sanghotran/CNCMicaMini/Software/CNCMicaMiniWPF/Images/debugscreen.png

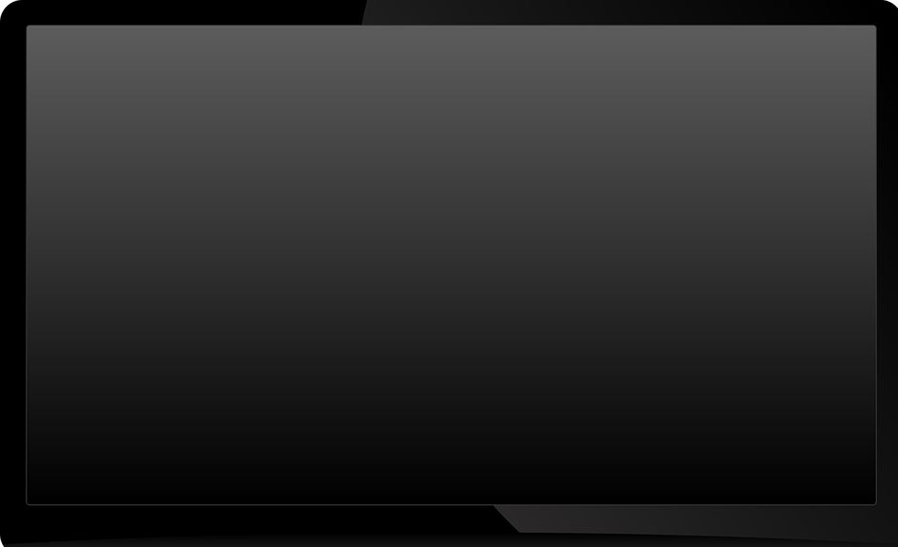
Software/CNCMicaMiniWPF/Images/debugscreen.png
