sanghotran/CNCMicaMini/Software/CNCMicaMiniWPF/Images/Debug.png

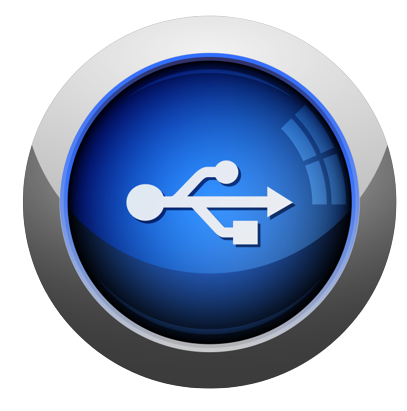
Software/CNCMicaMiniWPF/Images/Debug.png
