sanghotran/CNCMicaMini/Software/CNCMicaMiniWPF/packages/System.Buffers.4.4.0/version.txt

8321c729934c0f8be754953439b88e6e1c120c24
