sanghotran/CNCMicaMini/Hardware/Product/top.jpg

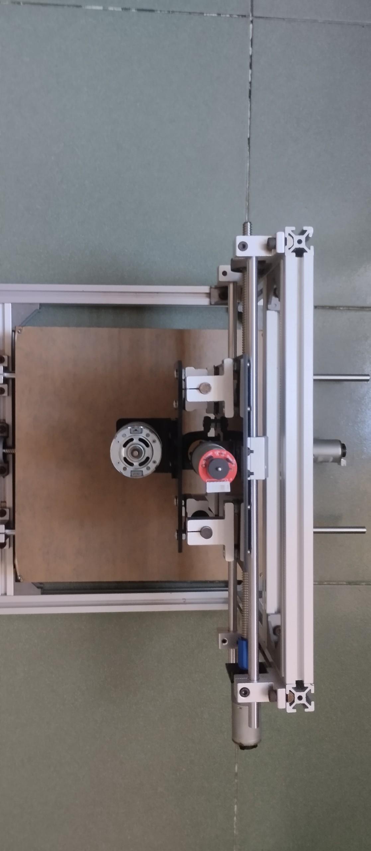
Hardware/Product/top.jpg
