sanghotran/CNCMicaMini/Software/CNCMicaMiniWPF/Images/-.png

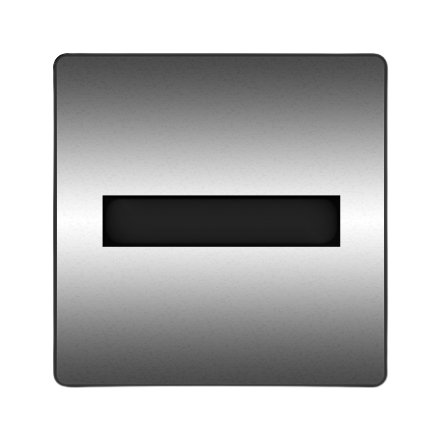
Software/CNCMicaMiniWPF/Images/-.png
