sanghotran/CNCMicaMini/Software/CNCMicaMiniWPF/Images/bluebutton.png

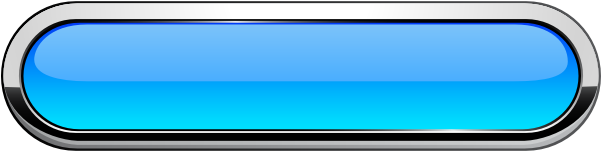
Software/CNCMicaMiniWPF/Images/bluebutton.png
