sanghotran/CNCMicaMini/Software/CNCMicaMiniWPF/Images/blueframeneon.png

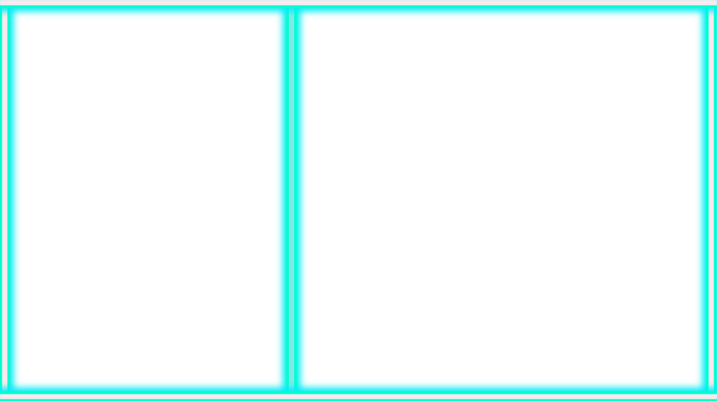
Software/CNCMicaMiniWPF/Images/blueframeneon.png
