sanghotran/CNCMicaMini/Software/CNCMicaMiniWPF/Images/downarrow.png

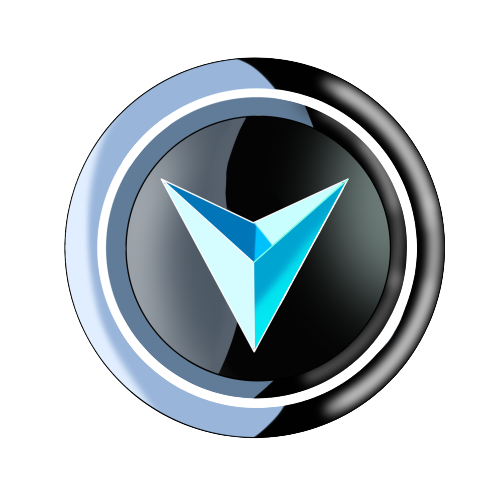
Software/CNCMicaMiniWPF/Images/downarrow.png
