sanghotran/CNCMicaMini/Software/CNCMicaMiniWPF/Images/gblueframeneon.png

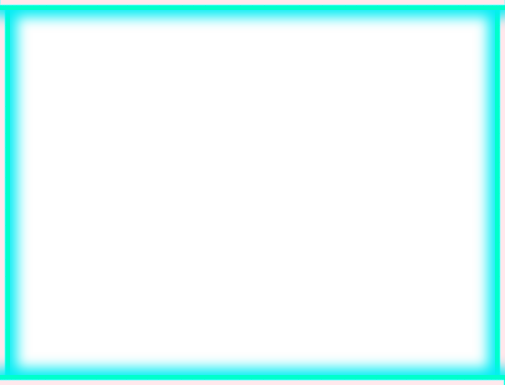
Software/CNCMicaMiniWPF/Images/gblueframeneon.png
