sanghotran/CNCMicaMini/Software/CNCMicaMiniWPF/Images/Home.png

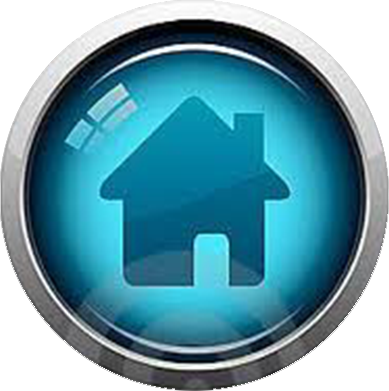
Software/CNCMicaMiniWPF/Images/Home.png
