sanghotran/CNCMicaMini/Software/CNCMicaMiniWPF/Images/leftarrow.png

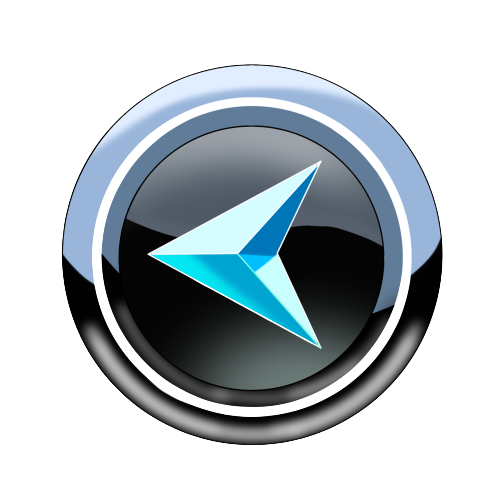
Software/CNCMicaMiniWPF/Images/leftarrow.png
