sanghotran/CNCMicaMini/Software/CNCMicaMiniWPF/Images/redarrowneon.png

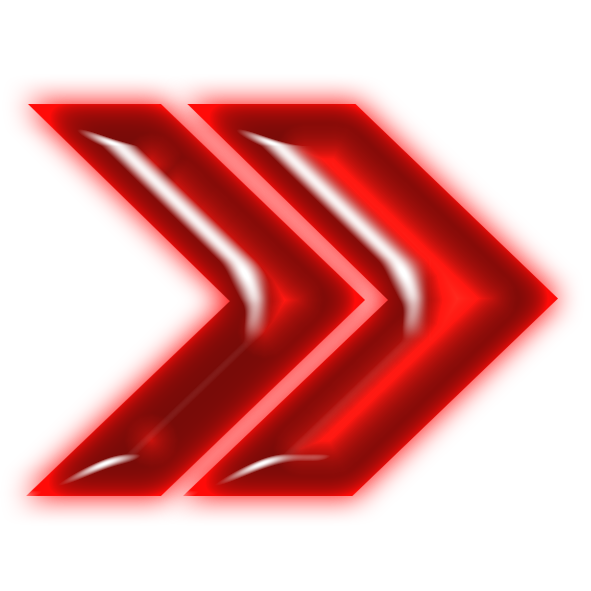
Software/CNCMicaMiniWPF/Images/redarrowneon.png
