sanghotran/CNCMicaMini/Software/CNCMicaMiniWPF/Images/rightarrow.png

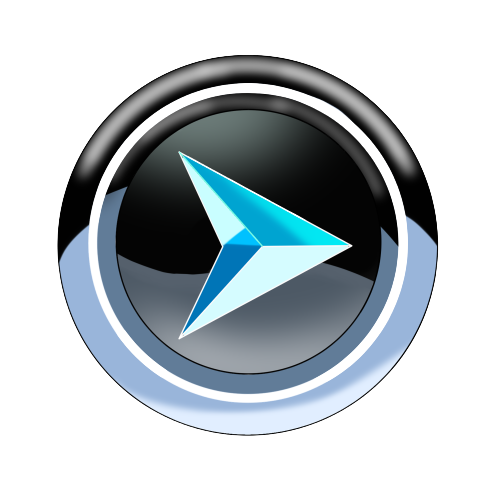
Software/CNCMicaMiniWPF/Images/rightarrow.png
