sanghotran/CNCMicaMini/Software/CNCMicaMiniWPF/Images/uparrow.png

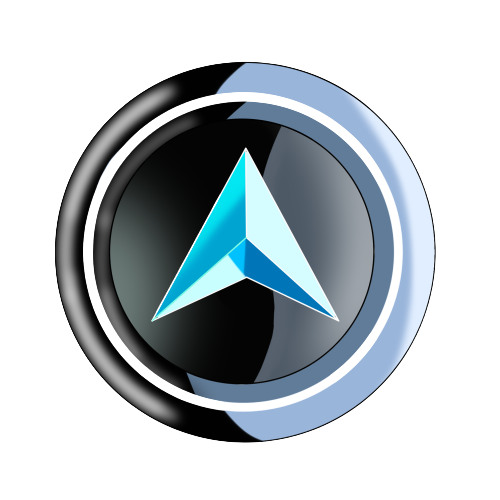
Software/CNCMicaMiniWPF/Images/uparrow.png
