sanghotran/CNCMicaMini/Software/CNCMicaMiniWPF/Images/warningbox.jpg

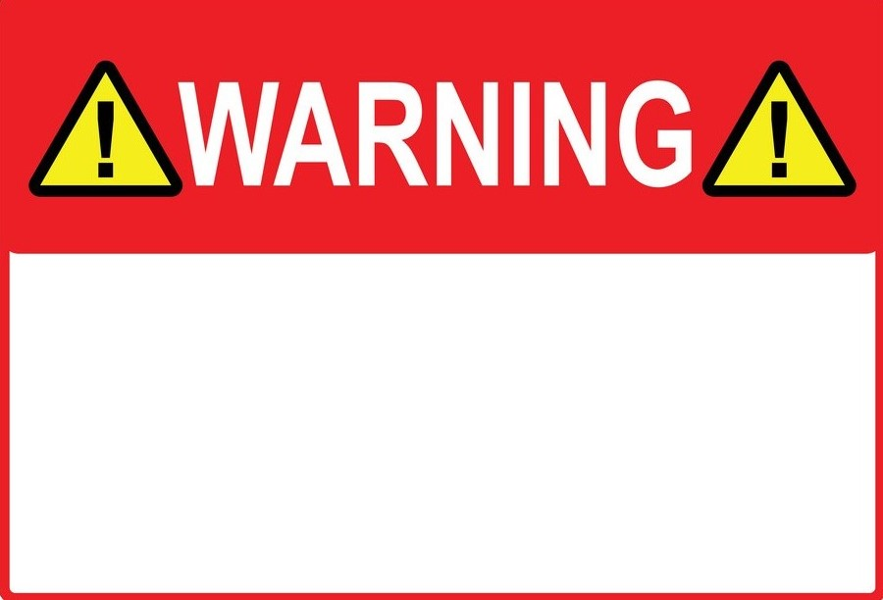
Software/CNCMicaMiniWPF/Images/warningbox.jpg
