sanghotran/CNCMicaMini/Software/CNCMicaMiniWPF/Images/x.png

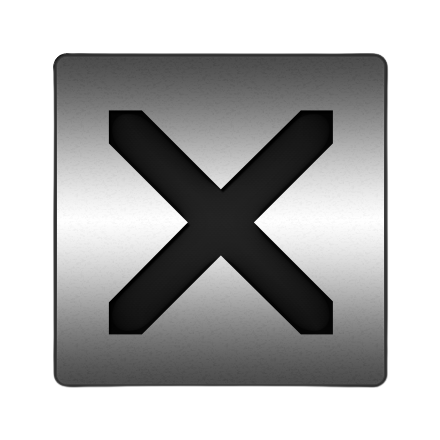
Software/CNCMicaMiniWPF/Images/x.png
