sanghotran/CNCMicaMini/Hardware/Cut_mica/Oyz.DXF

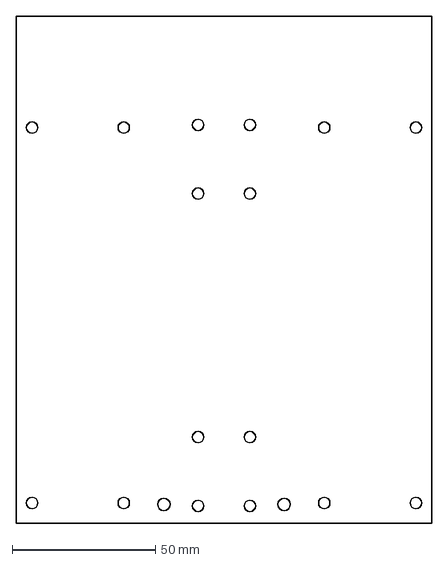
[picture p39: CAD file, 2022-07-27]
Hardware/Cut_mica/Oyz.DXF
145.0 x 177.0 mm
