sanghotran/CNCMicaMini/Hardware/Frame/Oyz.SLDPRT

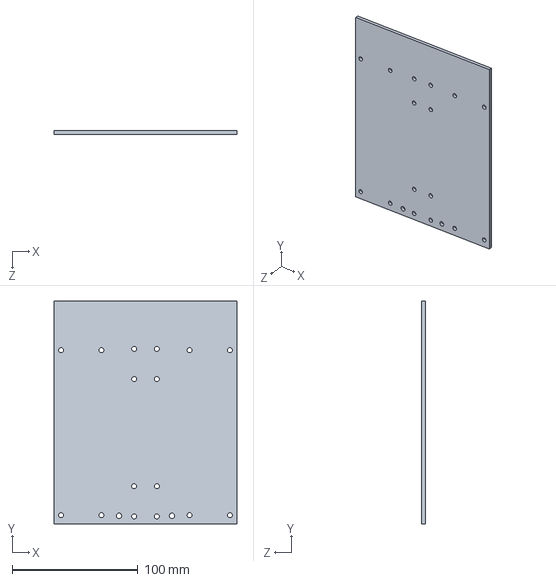
[picture p40: CAD file, 2022-07-27]
Hardware/Frame/Oyz.SLDPRT
145.0 x 177.0 x 3.00 mm
