sanghotran/CNCMicaMini/Hardware/Cut_mica/Table_Z.DXF

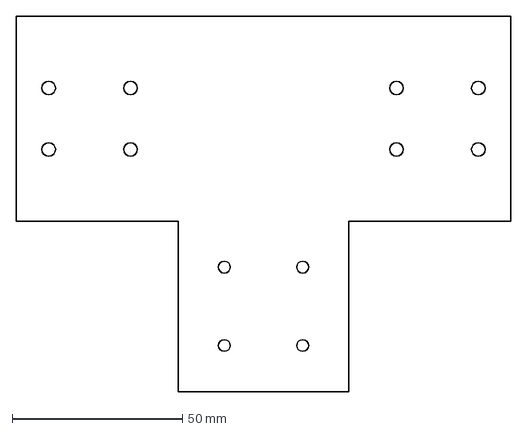
[picture p41: CAD file, 2022-06-26]
Hardware/Cut_mica/Table_Z.DXF
145.0 x 110.0 mm
