sanghotran/CNCMicaMini/Hardware/Frame/Prop_motor.SLDPRT

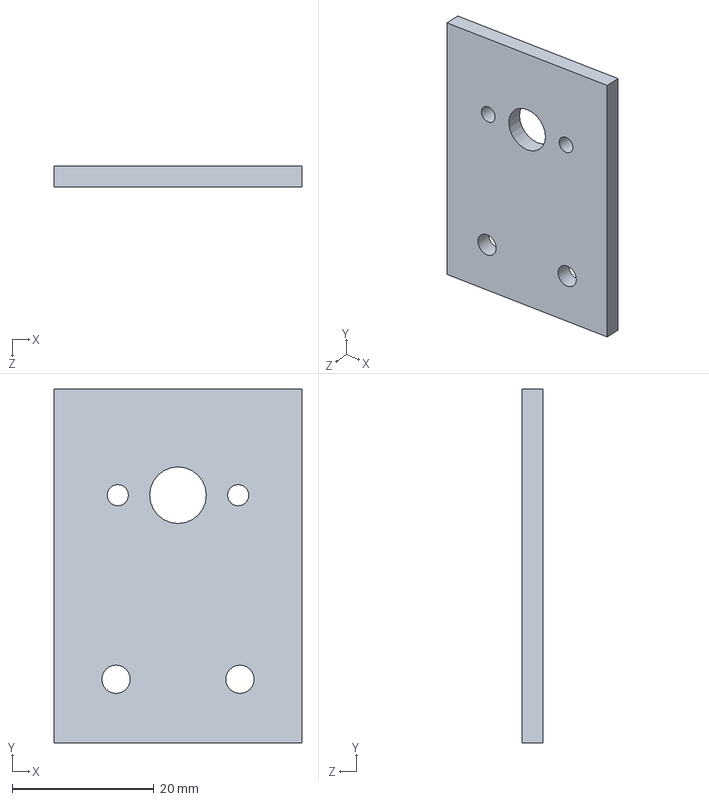
[picture p42: CAD file, 2022-06-26]
Hardware/Frame/Prop_motor.SLDPRT
35.0 x 50.0 x 3.00 mm
