sanghotran/CNCMicaMini/Hardware/Cut_mica/Table_bot.DXF

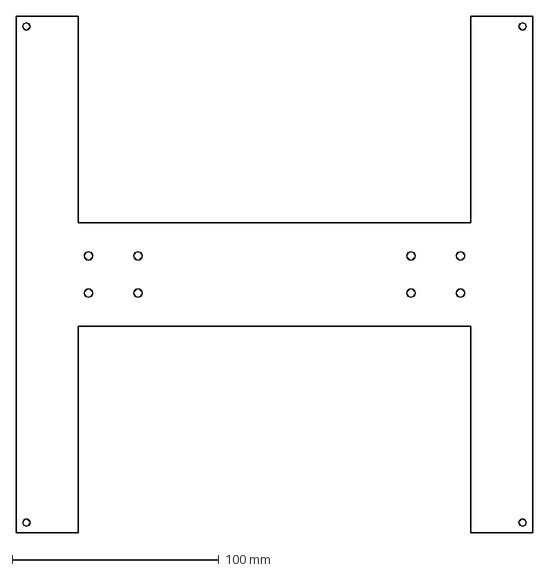
[picture p43: CAD file, 2022-06-26]
Hardware/Cut_mica/Table_bot.DXF
250.0 x 250.0 mm
