sanghotran/CNCMicaMini/Hardware/Frame/Table_bot.SLDPRT

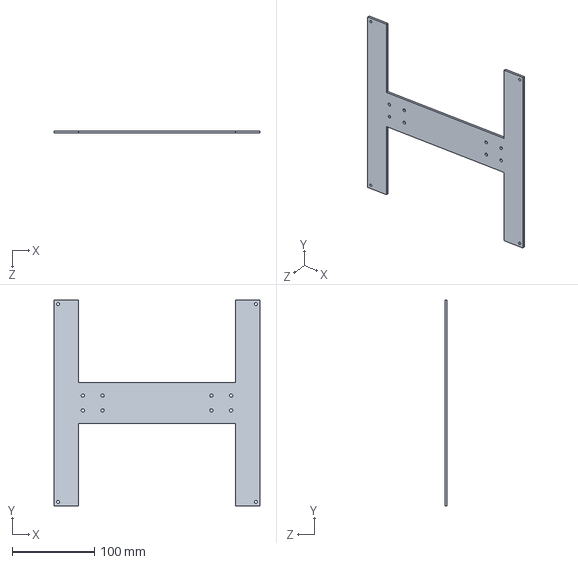
[picture p44: CAD file, 2022-06-26]
Hardware/Frame/Table_bot.SLDPRT
250.0 x 250.0 x 3.00 mm
