sanghotran/CNCMicaMini/Hardware/Cut_mica/Prop_motor.DXF

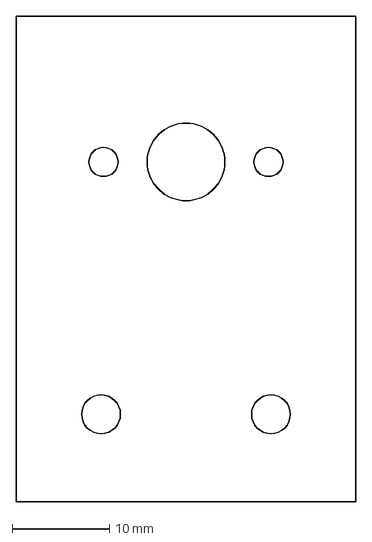
[picture p45: CAD file, 2022-06-26]
Hardware/Cut_mica/Prop_motor.DXF
35.0 x 50.0 mm
