sanghotran/CNCMicaMini/Hardware/Frame/Table_Z.SLDPRT

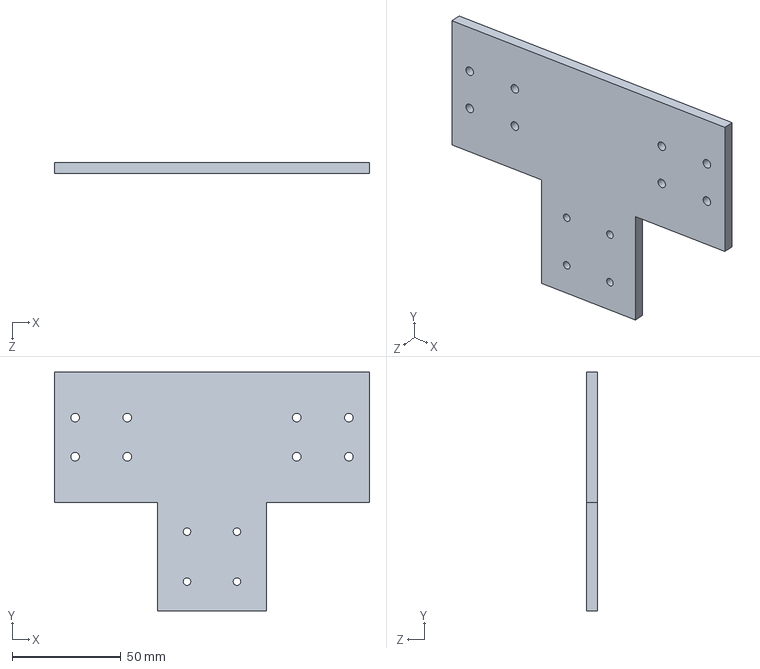
[picture p46: CAD file, 2022-06-26]
Hardware/Frame/Table_Z.SLDPRT
145.0 x 110.0 x 5.00 mm
