sanghotran/CNCMicaMini/Hardware/Cut_mica/Table_top.DXF

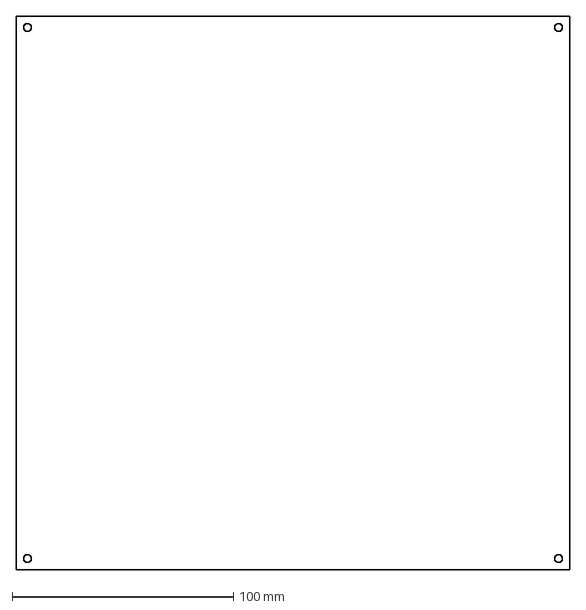
[picture p47: CAD file, 2022-06-26]
Hardware/Cut_mica/Table_top.DXF
250.0 x 250.0 mm
