sanghotran/CNCMicaMini/Hardware/Frame/Table_top.SLDPRT

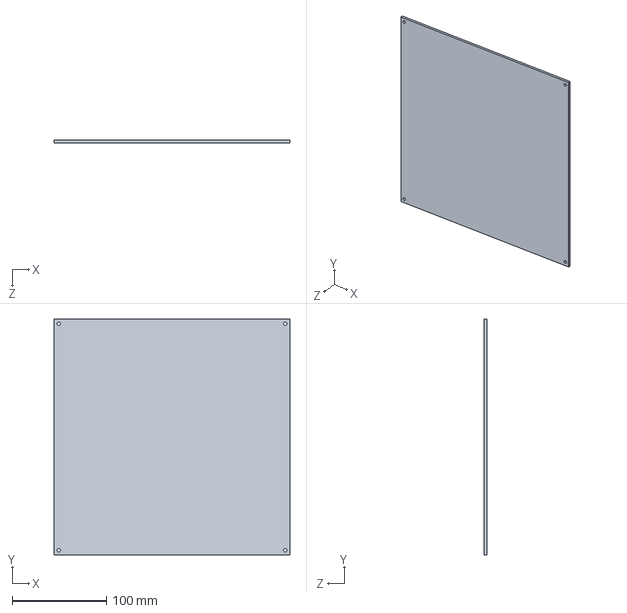
[picture p48: CAD file, 2022-06-26]
Hardware/Frame/Table_top.SLDPRT
250.0 x 250.0 x 3.00 mm
