sanghotran/CNCMicaMini/Hardware/CNCMicaMini/CNCMicaMini_Schematic.pdf

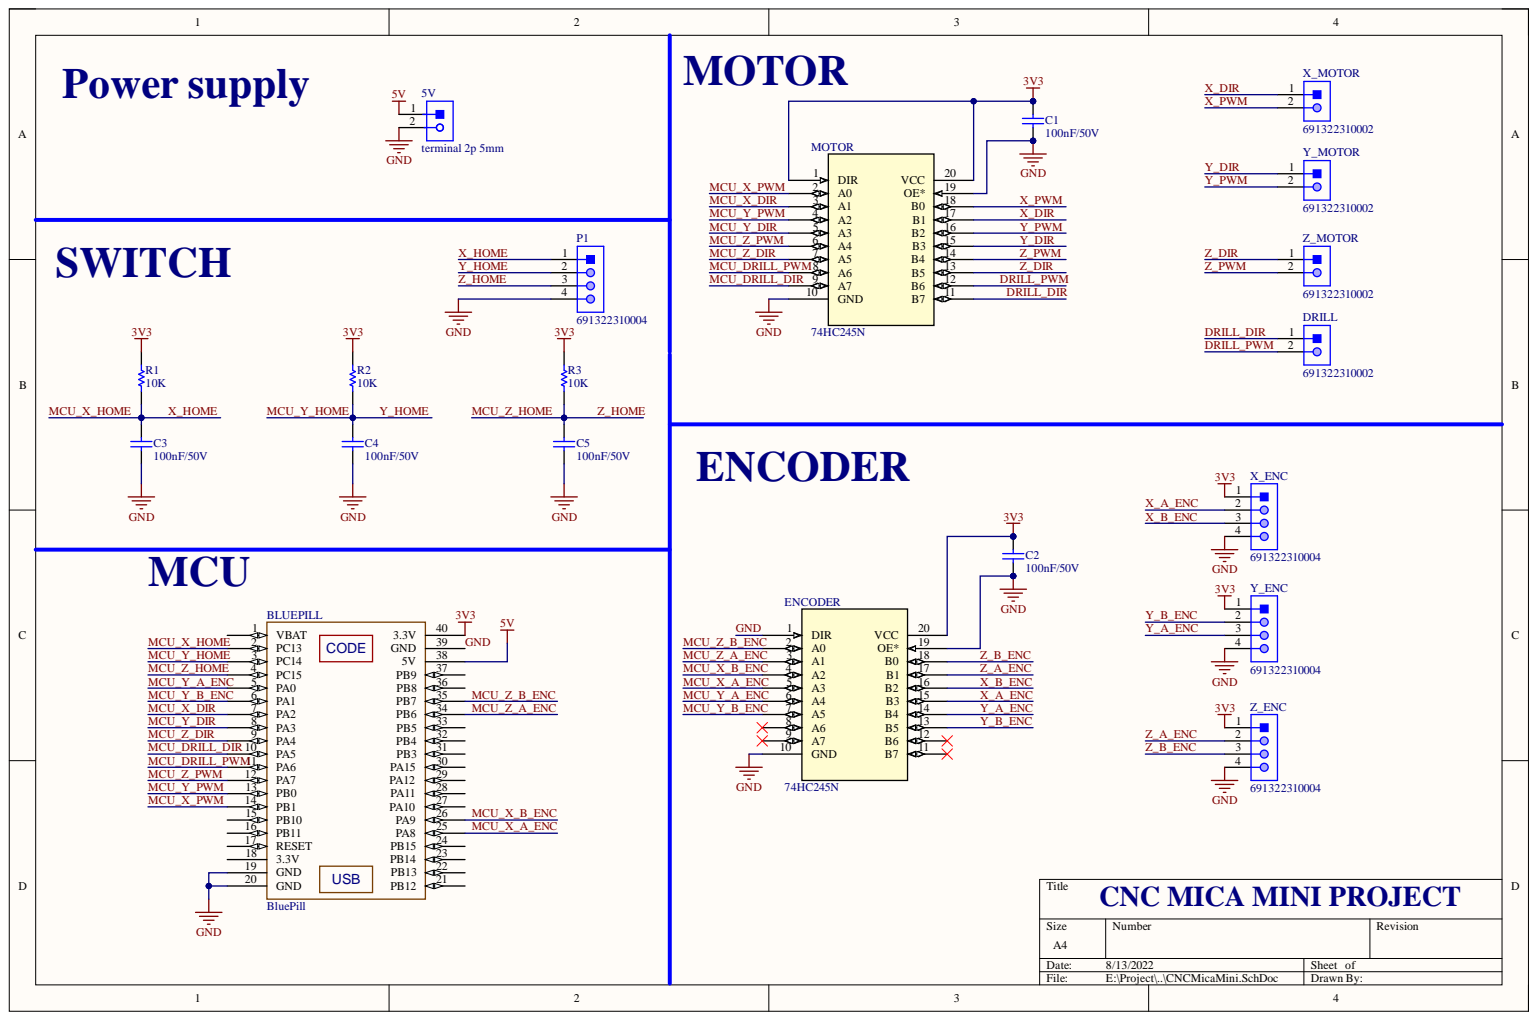
[picture p49: page 1]

CNC MICA MINI PROJECT
