sanghotran/CNCMicaMini/Hardware/CNCMicaMini/CNCMicaMini_PCB.pdf

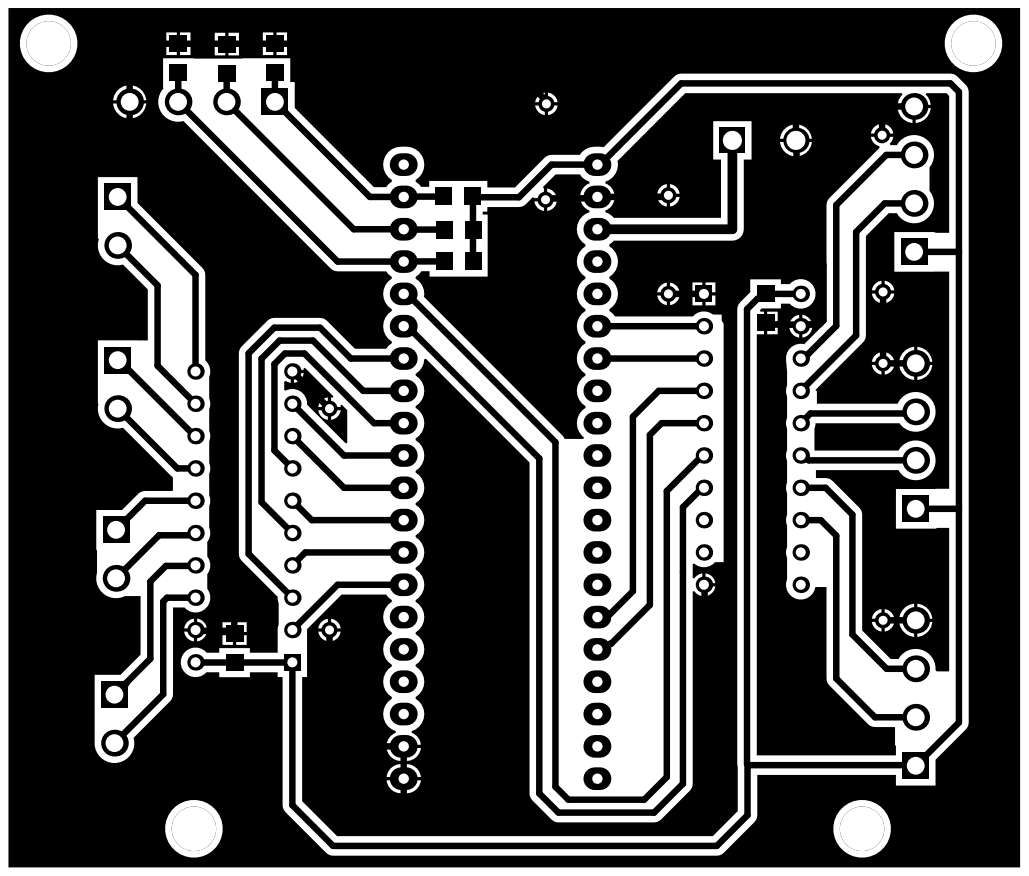
[picture p50: page 1]
