sanghotran/CNCMicaMini/Hardware/CNCMicaMini/PCBPrint/PCBPrint.pdf

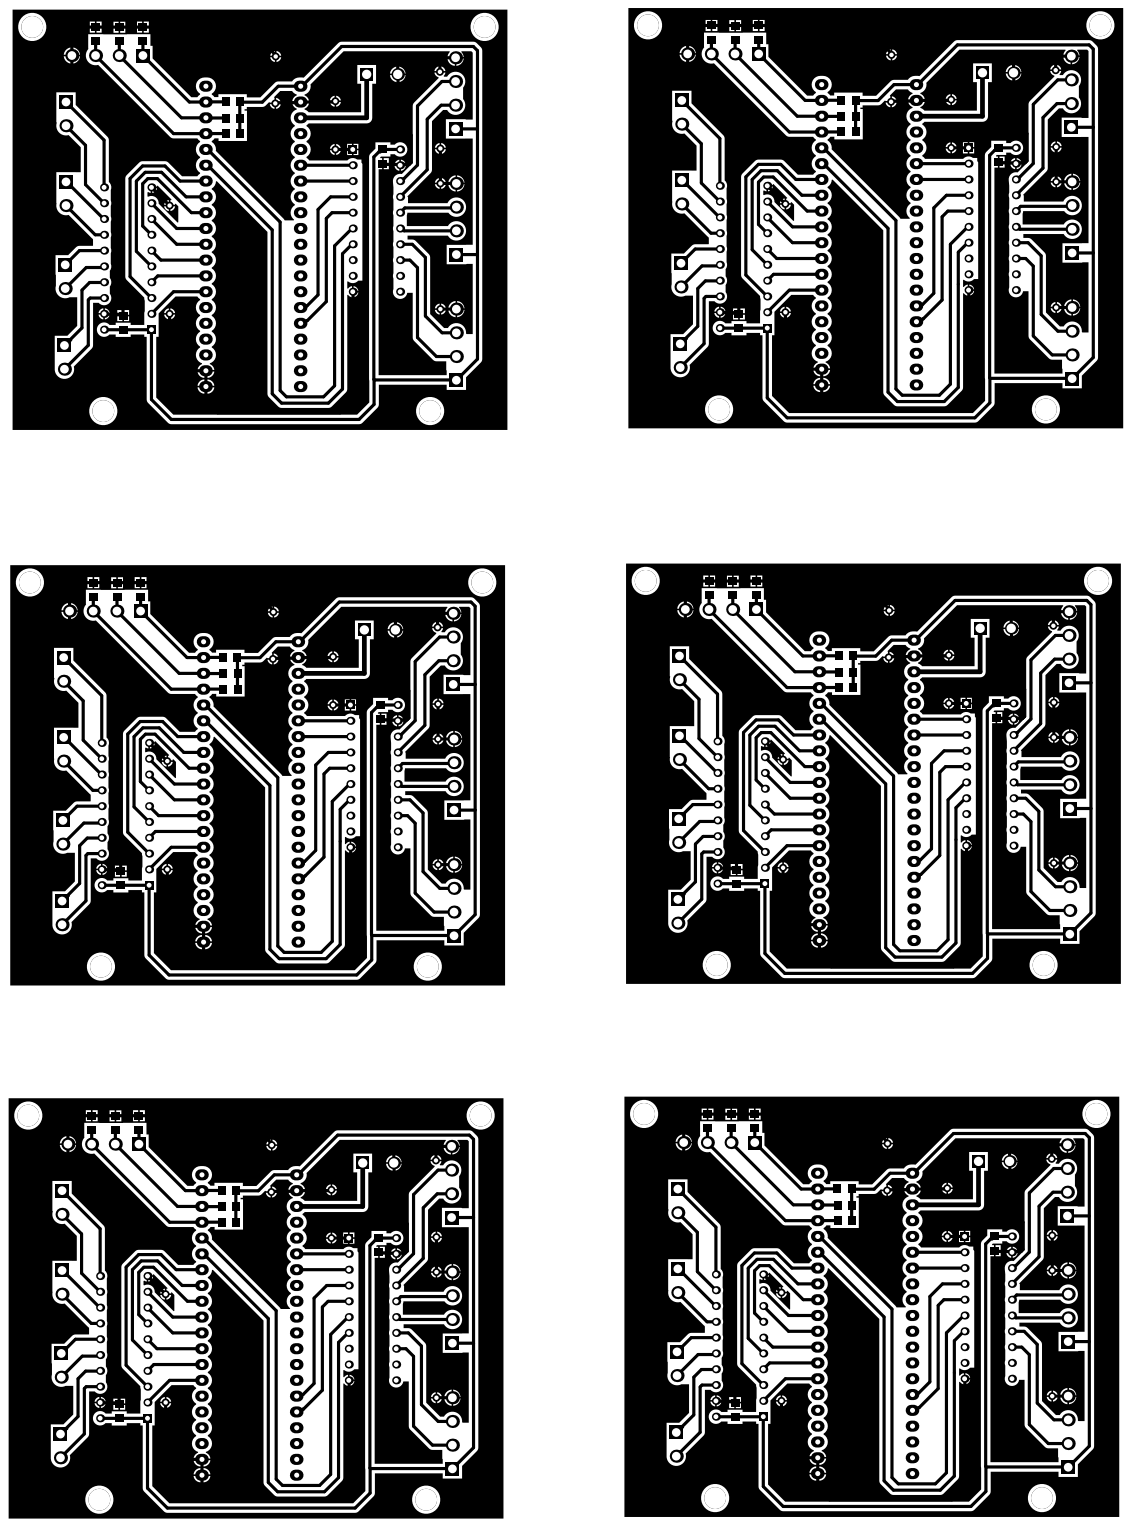
[picture p51: page 1]
