sanghotran/CNCMicaMini/Hardware/CNCMicaMini/Project Outputs for CNCMicaMini/CNCMicaMini(2022-04-02)/CNCMicaMini(2022-04-02-16-01).PDF

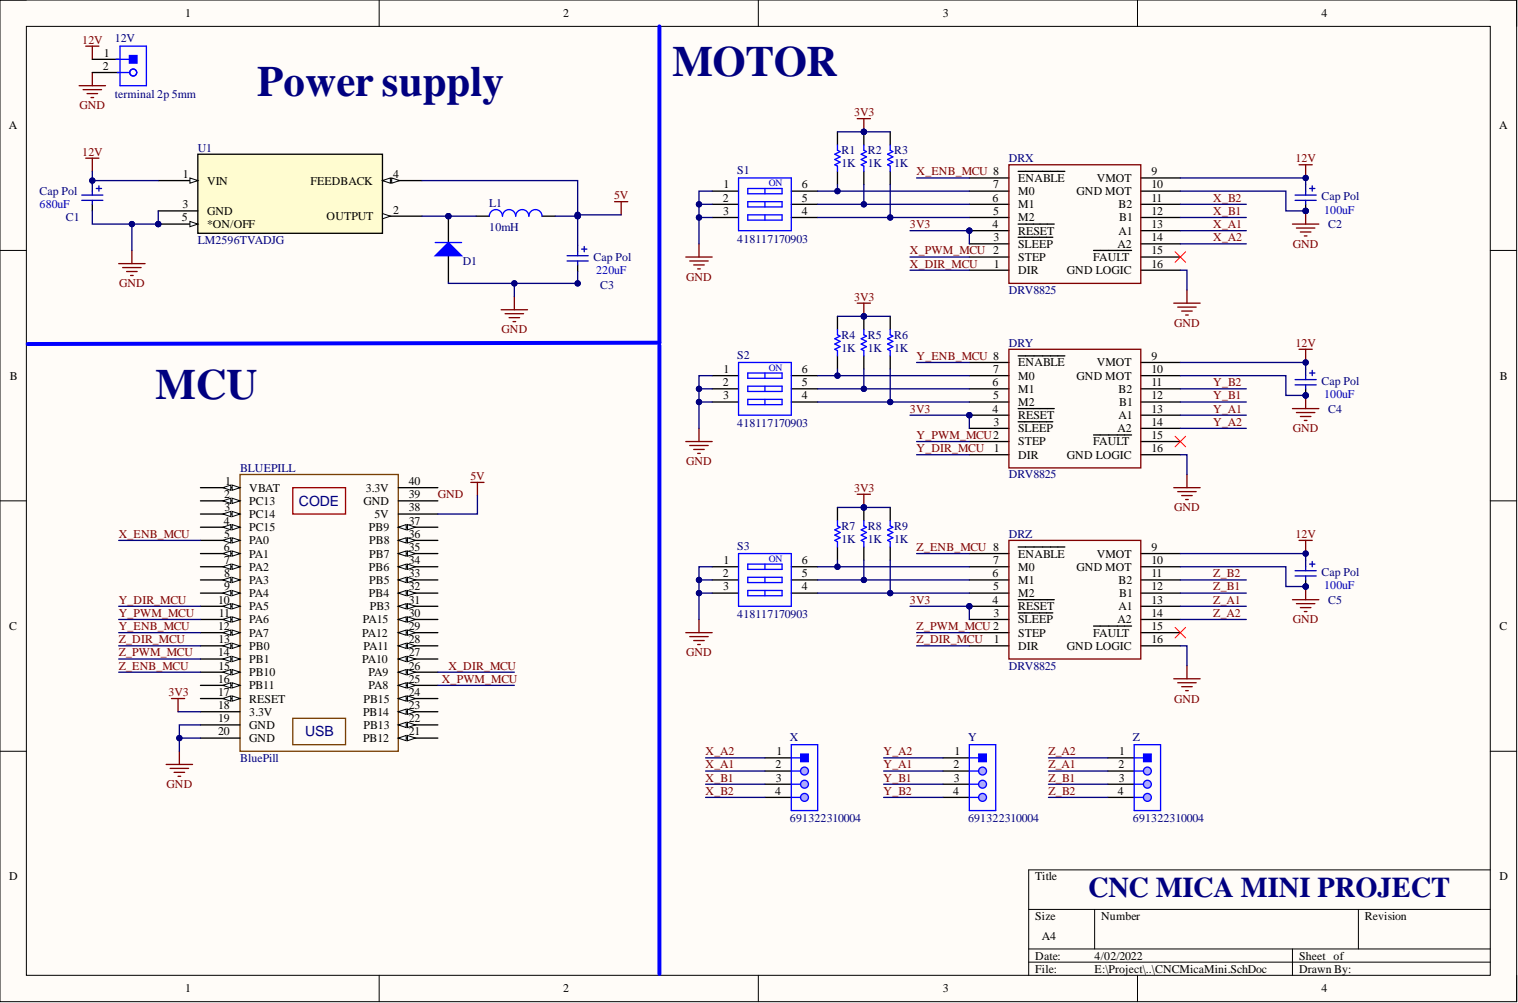
[picture p52: page 1]

CNC MICA MINI PROJECT

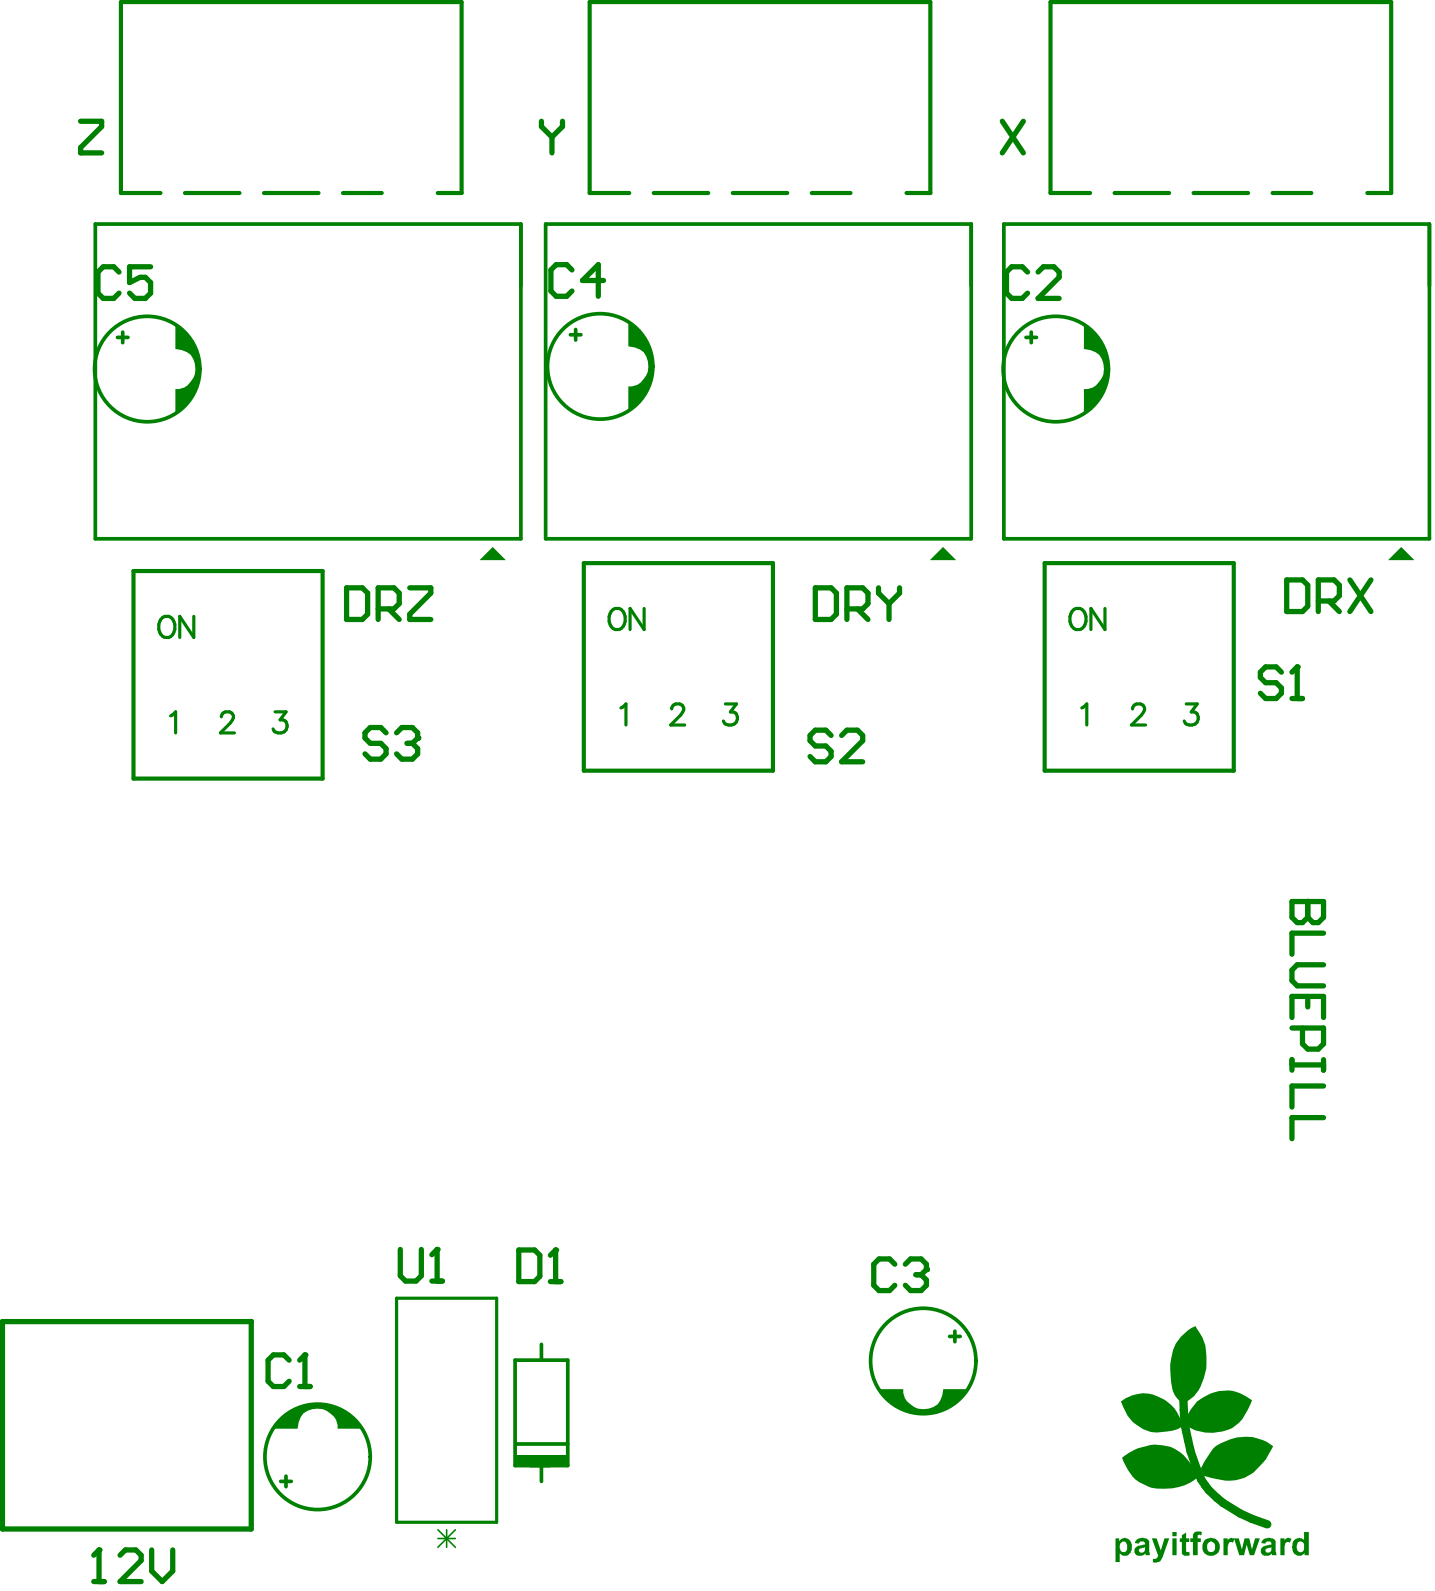
[picture p53: page 2]

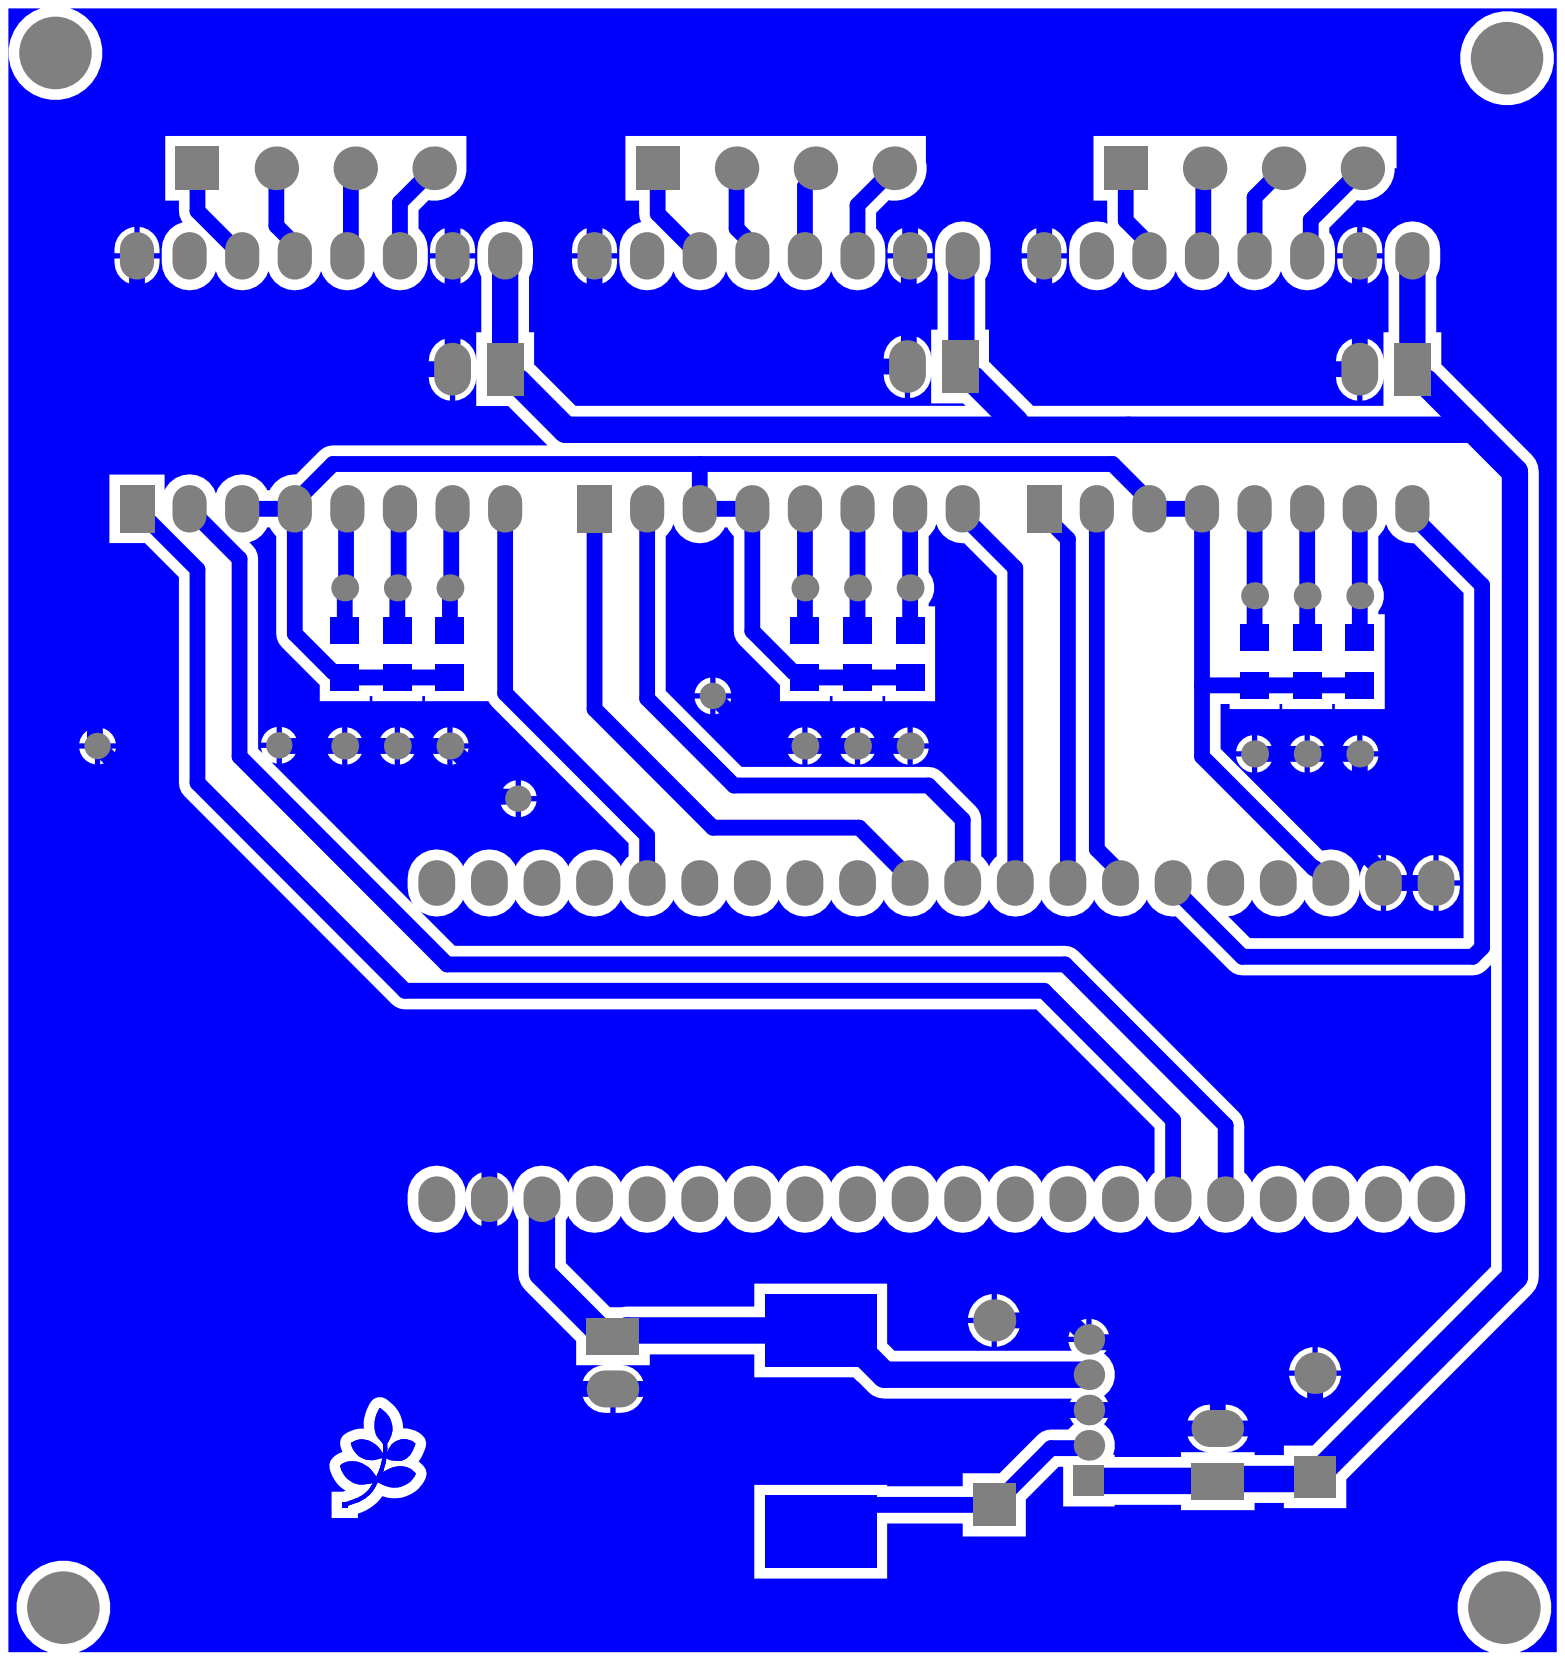
[picture p54: page 3]

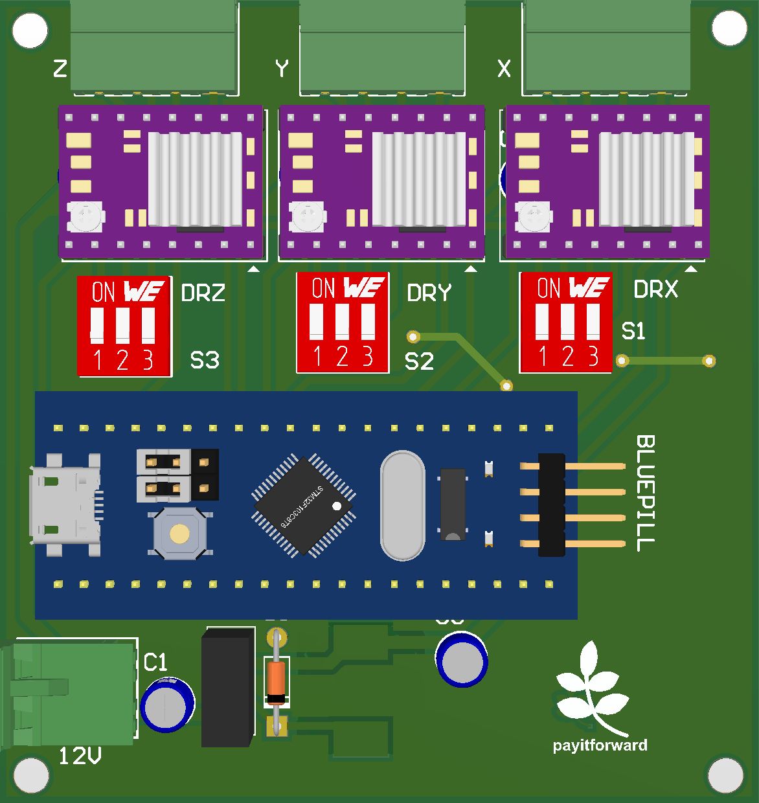
[picture p55: page 4]

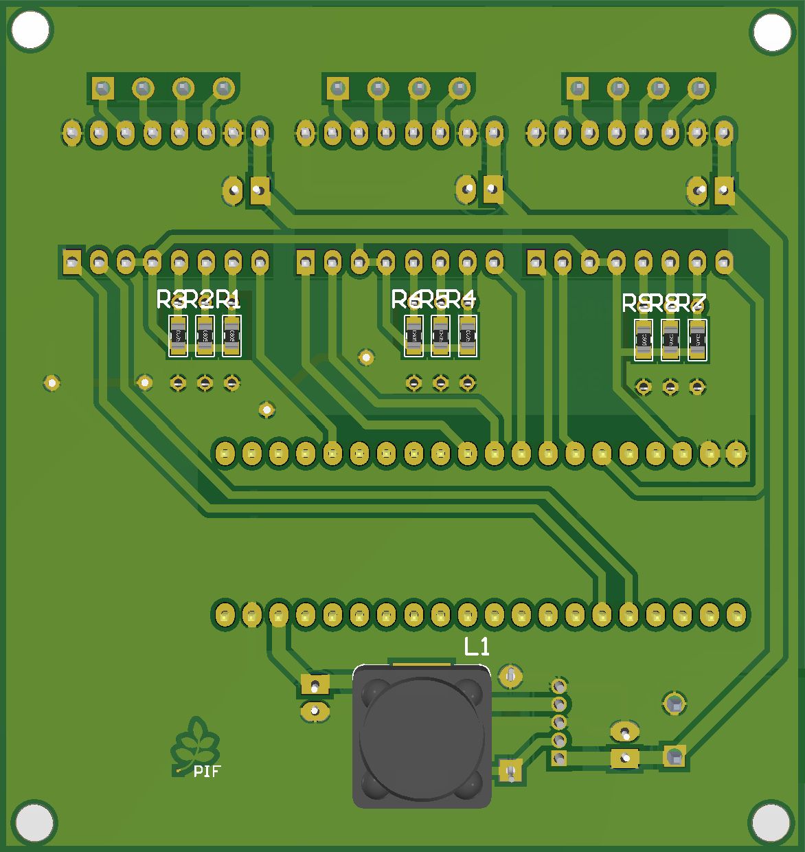
[picture p56: page 5]
