sanghotran/CNCMicaMini/(list of files, drawings)

Other design files:
Hardware/CNCMicaMini/CNCMicaMini.PcbDoc
Hardware/CNCMicaMini/CNCMicaMini.PrjPcb
Hardware/CNCMicaMini/CNCMicaMini.SchDoc
Hardware/CNCMicaMini/CNCMicaMini_Pre.PcbDoc
