sanghotran/CNCMicaMini/Firmware/CNC_Mica_Mini/CNCMicaMini/Core/Src/main.c

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
/* Includes ------------------------------------------------------------------*/
#include "main.h"
#include "usb_device.h"

/* USER CODE BEGIN Includes */
#include "usbd_customhid.h"
#include "usbd_custom_hid_if.h"
#include <stdbool.h>

/* USER CODE END Includes */

/* USER CODE BEGIN PTD */
enum
{
	Idle = 0,
	Gcode,
	Home,
	Calib,
	Drill,
	Home_1cm
}CNC_Mode_main;
/* USER CODE END PTD */

/* USER CODE BEGIN PD */

#define TS 0.03
/* USER CODE END PD */

TIM_HandleTypeDef htim1;
TIM_HandleTypeDef htim2;
TIM_HandleTypeDef htim3;
TIM_HandleTypeDef htim4;

/* USER CODE BEGIN PV */

AXIS x_axis;
AXIS y_axis;
AXIS z_axis;

uint8_t process_mode = Idle;
float thickness = 0;
float I;
float J;

bool drill_status = false;

DATA data;

extern USBD_HandleTypeDef hUsbDeviceFS;
extern uint8_t _cncState;

/* USER CODE END PV */

void SystemClock_Config(void);
static void MX_GPIO_Init(void);
static void MX_TIM1_Init(void);
static void MX_TIM3_Init(void);
static void MX_TIM2_Init(void);
static void MX_TIM4_Init(void);
/* USER CODE BEGIN PFP */

void axisInit(void);
//void drawLine(AXIS *pXAxis, AXIS *pYAxis, DATA *pdata,USBD_HandleTypeDef *usbd );
//void move(AXIS *axis, float pos);


/* USER CODE END PFP */

/* USER CODE BEGIN 0 */

// Interupt
void HAL_GPIO_EXTI_Callback(uint16_t GPIO_Pin)
{
  UNUSED(GPIO_Pin);
	// X Home
	if( GPIO_Pin == GPIO_PIN_13)
	{
		x_axis.pwm = 0;
		PWM(&x_axis);
		x_axis.home = true;
	}
	// Y Home
	if( GPIO_Pin == GPIO_PIN_14)
	{
		y_axis.pwm = 0;
		PWM(&y_axis);
		y_axis.home = true;
	}
	// Z Home
	if( GPIO_Pin == GPIO_PIN_15)
	{
		z_axis.pwm = 0;
		PWM(&z_axis);
		z_axis.home = true;
	}
}



// Function 
void axisInit()
{
	x_axis.htim_motor = &htim3;
	y_axis.htim_motor = &htim3;
	z_axis.htim_motor = &htim3;
	
	x_axis.htim_enc = &htim1;
	y_axis.htim_enc = &htim2;
	z_axis.htim_enc = &htim4;
	
	x_axis.GPIO_DIR = GPIOA;
	y_axis.GPIO_DIR = GPIOA;
	z_axis.GPIO_DIR = GPIOA;
	
	x_axis.PIN_DIR = GPIO_PIN_2;
	y_axis.PIN_DIR = GPIO_PIN_3;
	z_axis.PIN_DIR = GPIO_PIN_4;
	
	x_axis.CHANNEL = TIM_CHANNEL_4;
	y_axis.CHANNEL = TIM_CHANNEL_3;
	z_axis.CHANNEL = TIM_CHANNEL_2;
	
	x_axis.GPIO_HOME = GPIOC;
	y_axis.GPIO_HOME = GPIOC;
	z_axis.GPIO_HOME = GPIOC;
	
	x_axis.PIN_HOME = GPIO_PIN_13;
	y_axis.PIN_HOME = GPIO_PIN_14;
	z_axis.PIN_HOME = GPIO_PIN_15;
	
	x_axis.Kp = 2;
	y_axis.Kp = 20;
	z_axis.Kp = 0.7;
	
	x_axis.Ki = 0.0001;
	y_axis.Ki = 0.0001;
	z_axis.Ki = 0.0001;
	
	x_axis.Kd = 0.15;
	y_axis.Kd = 0.2;
	z_axis.Kd = 0.02;
	
	x_axis.mm_pulse = 249.8886;//142.8571;
	y_axis.mm_pulse = 495.1475;//333.3333;
	z_axis.mm_pulse = 500;
}
/* USER CODE END 0 */

/**
  * @brief  The application entry point.
  * @retval int
  */
int main(void)
{
  /* MCU Configuration--------------------------------------------------------*/

  /* Reset of all peripherals, Initializes the Flash interface and the Systick. */
  HAL_Init();

  /* Configure the system clock */
  SystemClock_Config();

  /* Initialize all configured peripherals */
  MX_GPIO_Init();
  MX_TIM1_Init();
  MX_TIM3_Init();
  MX_USB_DEVICE_Init();
  MX_TIM2_Init();
  MX_TIM4_Init();
  /* USER CODE BEGIN 2 */
	
	// Init axis
	axisInit();
	
	// Start PWM
	HAL_TIM_PWM_Start(&htim3, TIM_CHANNEL_1);
	HAL_TIM_PWM_Start(&htim3, TIM_CHANNEL_2);
	HAL_TIM_PWM_Start(&htim3, TIM_CHANNEL_3);
	HAL_TIM_PWM_Start(&htim3, TIM_CHANNEL_4);
	
	// Start Encoder
	HAL_TIM_Encoder_Start(&htim1, TIM_CHANNEL_1 | TIM_CHANNEL_2);
	HAL_TIM_Encoder_Start(&htim2, TIM_CHANNEL_1 | TIM_CHANNEL_2);
	HAL_TIM_Encoder_Start(&htim4, TIM_CHANNEL_1 | TIM_CHANNEL_2);

  /* USER CODE END 2 */

  /* Infinite loop */
  /* USER CODE BEGIN WHILE */
  while (1)
  {
		// mode drill control
		if(process_mode == Drill)
		{
			// avoid intterupt accident 
			//x_axis.pwm = 0;
		  //PWM(&x_axis);
			//y_axis.pwm = 0;
		  //PWM(&y_axis);
			
			
			
			/*if( drill_status != z_axis.drill)
			
			{
				if(z_axis.drill)
				{
					z_axis.last = 1;
					move(&z_axis, thickness);
				}
				else
				{
					z_axis.last = 0;
					move(&z_axis, 0);
				}
				if(z_axis.finish)
				{
					z_axis.finish = false;
				  drill_status = z_axis.drill;
					HAL_Delay(200);		
				}
			}
			else
				process_mode = Gcode;*/
				
				if(drill_status != z_axis.drill)
				{
					if(z_axis.drill)
						z_axis.next = thickness;
					else
						z_axis.next = 0;					
					while(!z_axis.finish)
					{
						move(&z_axis, z_axis.next);
					}
					z_axis.finish = false;
					drill_status = z_axis.drill;
					process_mode = Gcode;		
				}
				else
					process_mode = Gcode;		
		}
		// mode gcode control
		if(process_mode == Gcode ) 
		{
			switch(_cncState)
			{ 				
				case 0: // move x y with z up
					while(!(x_axis.finish && y_axis.finish))
					{
						move(&x_axis, x_axis.next);
				    move(&y_axis, y_axis.next);	
					}
					x_axis.finish = false;
					y_axis.finish = false;
					x_axis.last = x_axis.next;
					y_axis.last = y_axis.next;
					break;
				
				case 1: // move x y with z down					
					drawLine(&x_axis, &y_axis);
					break; 
				
				case 2: // move x y with z down circle
					drawLine(&x_axis, &y_axis);
					break;
				
				case 3: // move x y wih z down circle 
					drawLine(&x_axis, &y_axis);
					break;
			}
			sprintf(data.TransBuff, "ACK R %d_RESUME_X%f Y%f Z%f", data.receive, x_axis.last, y_axis.last, z_axis.next);
			data.need++;
			USBD_CUSTOM_HID_SendReport(&hUsbDeviceFS, (uint8_t *)data.TransBuff, 45); // send command resume
   		process_mode = Idle; // idle mode
		}
		// mode goto home
		if( process_mode == Home) 
		{
			// goto x home
			HOME(&x_axis);
			
			// goto y home
			HOME(&y_axis);
			
			// goto z home
			HOME(&z_axis);
			
			if( x_axis.home && y_axis.home && z_axis.home)
			{
				x_axis.htim_enc->Instance->CNT = 0;
				y_axis.htim_enc->Instance->CNT = 0;
				z_axis.htim_enc->Instance->CNT = 0;
				
				x_axis.pos = 0;
				y_axis.pos = 0;
				z_axis.pos = 0;
				
				process_mode = Home_1cm; // to protect switch, goto home 1cm mode				
			}

		}
		// home 1cm
		if( process_mode == Home_1cm)
		{
			move(&x_axis, 10);
			move(&y_axis, 10);
			move(&z_axis, 10);
			if( x_axis.finish && y_axis.finish && z_axis.finish)
			{
				x_axis.finish = false;
				y_axis.finish = false;
				z_axis.finish = false;

				x_axis.htim_enc->Instance->CNT = 0;
				y_axis.htim_enc->Instance->CNT = 0;
				z_axis.htim_enc->Instance->CNT = 0;
				
				x_axis.pos = 0;
				y_axis.pos = 0;
				z_axis.pos = 0;
				
				sprintf(data.TransBuff, "ACK H %d_HOME %f", data.receive, thickness);				
				USBD_CUSTOM_HID_SendReport(&hUsbDeviceFS, (uint8_t *)data.TransBuff, 45);
				data.need++;
				
				process_mode = Idle;
			}
		}
    /* USER CODE END WHILE */

    /* USER CODE BEGIN 3 */
  }
  /* USER CODE END 3 */
}

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
