sanghotran/CNCMicaMini/(commit log)

2022-04-02 update pcb
    [2P.STEP, 74HC245N.PcbLib, 74HC245N.SchLib, CNCMicaMini.PcbDoc, CNCMicaMini.PrjPcb, CNCMicaMini.SchDoc, LM2596TVADJG.PcbLib, LM2596TVADJG.SchLib]
2022-04-02 update BOM
    [CNCMicaMini.PrjPcb, CNCMicaMiniBOM.xlsx]
2022-04-13 Refresh Project
    [2P.STEP, 74HC245N.PcbLib, 74HC245N.SchLib, LM2596TVADJG.PcbLib, LM2596TVADJG.SchLib, Regulador LM2596.step, SOT146-1_NXP.step, TO220-5_ONS.step]
2022-06-13 update WPF
    [CNCMicaMini.PcbDoc]
2022-06-26 created frame
    [CNCMicaMini.SchDoc, Oyz.DXF, Oyz.SLDPRT, Prop_motor.DXF, Prop_motor.SLDPRT, Table_Z.DXF, Table_Z.SLDPRT, Table_bot.DXF]
2022-07-27 create PCB
    [CNCMicaMini.PcbDoc, CNCMicaMini.PrjPcb, CNCMicaMini.SchDoc, CNCMicaMini_Pre.PcbDoc, Oyz.DXF, Oyz.SLDPRT]
2022-07-28 create PBCprint
    [CNCMicaMini.PrjPcb, CNCMicaMiniBOM.xlsx]
2022-08-03 upadate PCB
    [CNCMicaMini.PcbDoc, CNCMicaMini.PrjPcb, CNCMicaMini.SchDoc]
2022-08-09 change GUI
    [CNCMicaMini.PcbDoc]
2022-08-09 update multi thread for debug
2022-08-12 add setting PID
2022-08-12 add send PID
2022-08-13 update transceive data frame
2022-08-13 add auto scroll for print debug
2022-08-15 init encoder
2022-08-15 receive pid from GUI
2022-08-18 pid for x y z
2022-08-18 update home 1cm
2022-08-23 update HOME button
2022-09-22 fix overflow encoder
2022-09-22 update pid for axis
2022-09-29 fix step axis and kp y axis
    [MotorControl.c, MotorControl.h, main.c]
2022-09-30 update pid and mm per step
