sanghotran/CNCMicaMini/(notices)

Notices in the files:
Firmware/CNC_Mica_Mini/CNCMicaMini/Core/Src/main.c:
Copyright (c) 2022 STMicroelectronics.
All rights reserved.
This software is licensed under terms that can be found in the LICENSE file
